Norco-College-Rocketry/ProxyBox/PCBs/5v Power Bus Board/5v Power Bus Board BOM.ods

DESCRIPTION | P/N | VALUE | QTY
USB TYPE C CONNECTOR SOLDER | USB4215-03-A |  | 1
USB TYPE B CONNECTOR SOLDER | USB1125-GF-B |  | 6
SCREW TERMINAL P3.5MM 2POS | 284391-2 |  | 4
JST XH 2POS | B2B-XH-A(LF)(SN) |  | 15
Capacitor | REF1225102M035K | 1000uF 35v | 2
Diode | 1n4005 |  | 1
