Norco-College-Rocketry/ProxyBox/PCBs/PaC Board/PAC Board BOM.ods

DESC. | P/N | Value | QTY
Test Point | 36-4952-ND | N/A | 5
Capacitor |  | 680uF 25v | 2
Capacitor | C1210C104K8GACTU | 0.1uF 10v | 1
Molex 6pos Female crimp Connector housing | 43645-0600 |  | 1
Molex 6pos male solder THT Connector Housing | 43650-0619 |  | 1
Terminal MF 3.0 | 43030-0001 |  | 18
Molex 4pos Male Solder THT Connector Housing | 43045-0428 |  | 3
Molex 4pos Female crimp connector housing | 172952-0401 |  | 3
Voltage & Current Monitor IC | LTC2990IMS#PBF |  | 1
Current Sense Resistor | WSLP39211L000FEB | 1mOhm | 1
