Norco-College-Rocketry/ProxyBox/PCBs/Relay Board/Relay Board BOM.ods

DESC. | P/N | Value | QTY
Molex 6pos Female crimp Connector housing | 43645-0600 |  | 1
Molex 6pos male solder THT Connector Housing | 43650-0619 |  | 1
Terminal MF 3.0 | 43030-0001 |  | 4
SCREW TERMINAL P3.5MM 3POS | 284391-3 |  | 4
Efuse | NIS6151MT1TXG | 5v 1A | 1
Capacitor | HMK325C7475MN-TE | 4.7uF | 1
Capacitor | C1210C105K8RACTU | 1uF | 1
Resistor | ESR25JZPF2R00 | 2Ohms | 1
Resistor | TNPW12101K00BEEA | 1kOhms | 1
