Norco-College-Rocketry/ProxyBox/PCBs/XBee Pro THT Mounting PCB/XBee Pro THT Mounting PCB.ods

Desc | P/N | Value | QTY
Capacitor | KAF32GR71H105KU | 1uF 50v | 1
Capacitor | CL32B106KBVVPLE | 10uF 50v | 1
Capacitor | CL32Y476KPVVPNE | 47uF 50v | 1
