Norco-College-Rocketry/ProxyBox/PCBs/Load Cell Amp Board/Load Cell Amp Board Schematic.pdf

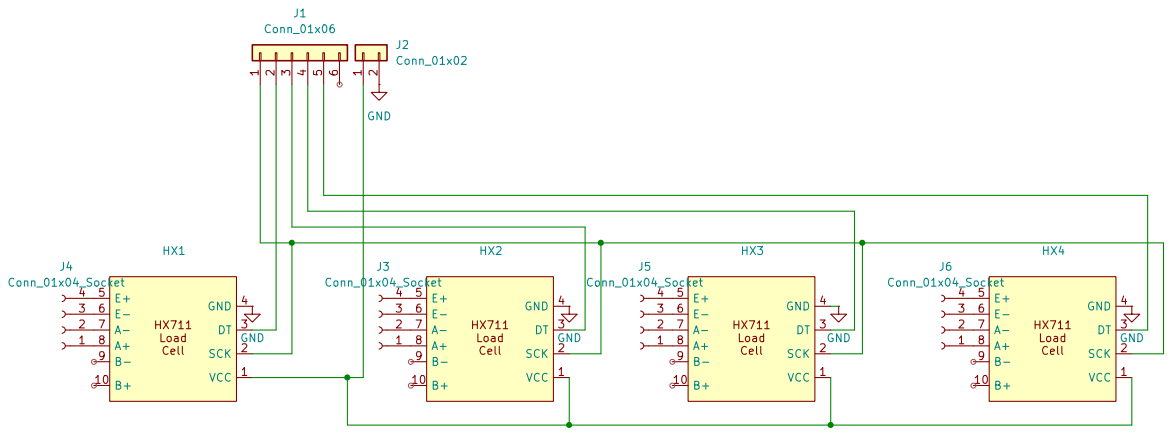
[picture p1: page 1]
