Norco-College-Rocketry/ProxyBox/PCBs/Load Cell Amp Board/Load Cell Amp Board.kicad_pcb

## KiCad design PCBs/Load Cell Amp Board/Load Cell Amp Board.kicad_pcb (2025-11-12)

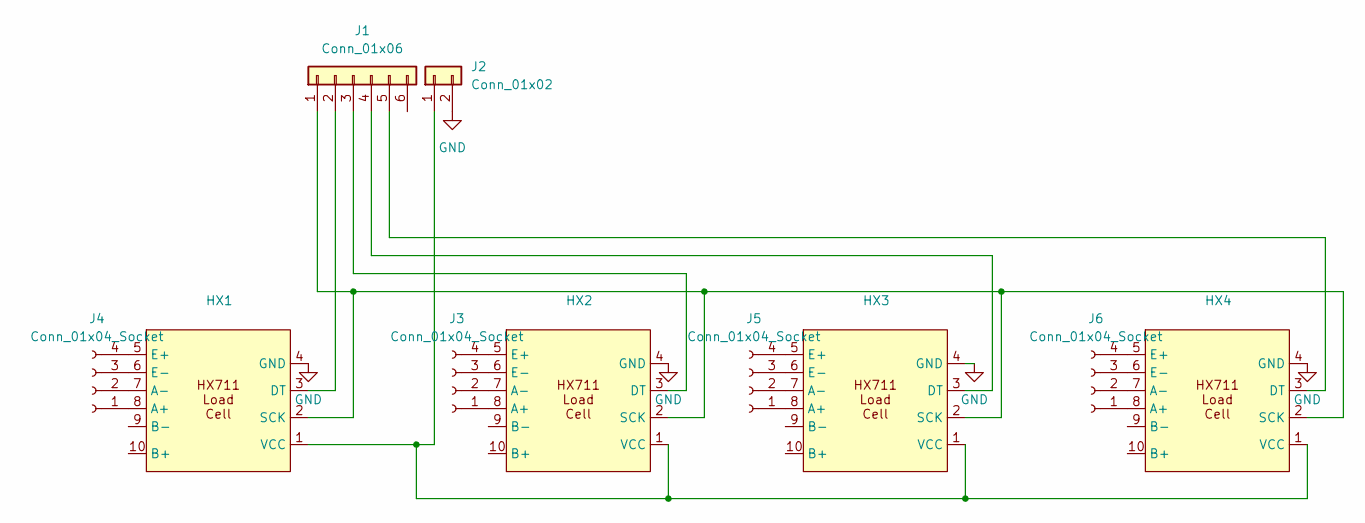
[picture p2: schematic Load Cell Amp Board.kicad_sch]

Parts:
HX1, HX2, HX3, HX4: HX711 Load Cell Amp Board
J1: Conn_01x06; Molex_Micro-Fit_3.0_43650-0619_1x06_P3.00mm_Vertical
J2: Conn_01x02; JST_XH_B2B-XH-A_1x02_P2.50mm_Vertical
J3, J4, J5, J6: Conn_01x04_Socket; Molex_Micro-Fit_3.0_43045-0412_2x02_P3.00mm_Vertical

Connections:
GND: HX1.4 (GND), HX2.4 (GND), HX3.4 (GND), HX4.4 (GND), J2.2
unnamed: HX1.8 (A+), J4.1
unnamed: HX1.7 (A-), J4.2
unnamed: HX1.3 (DT), J1.2
unnamed: HX1.5 (E+), J4.4
unnamed: HX1.6 (E-), J4.3
unnamed: HX1.2 (SCK), HX2.2 (SCK), HX3.2 (SCK), HX4.2 (SCK), J1.1
unnamed: HX1.1 (VCC), HX2.1 (VCC), HX3.1 (VCC), HX4.1 (VCC), J2.1
unnamed: HX2.8 (A+), J3.1
unnamed: HX2.7 (A-), J3.2
unnamed: HX2.3 (DT), J1.3
unnamed: HX2.5 (E+), J3.4
unnamed: HX2.6 (E-), J3.3
unnamed: HX3.8 (A+), J5.1
unnamed: HX3.7 (A-), J5.2
unnamed: HX3.3 (DT), J1.4
unnamed: HX3.5 (E+), J5.4
unnamed: HX3.6 (E-), J5.3
unnamed: HX4.8 (A+), J6.1
unnamed: HX4.7 (A-), J6.2
unnamed: HX4.3 (DT), J1.5
unnamed: HX4.5 (E+), J6.4
unnamed: HX4.6 (E-), J6.3

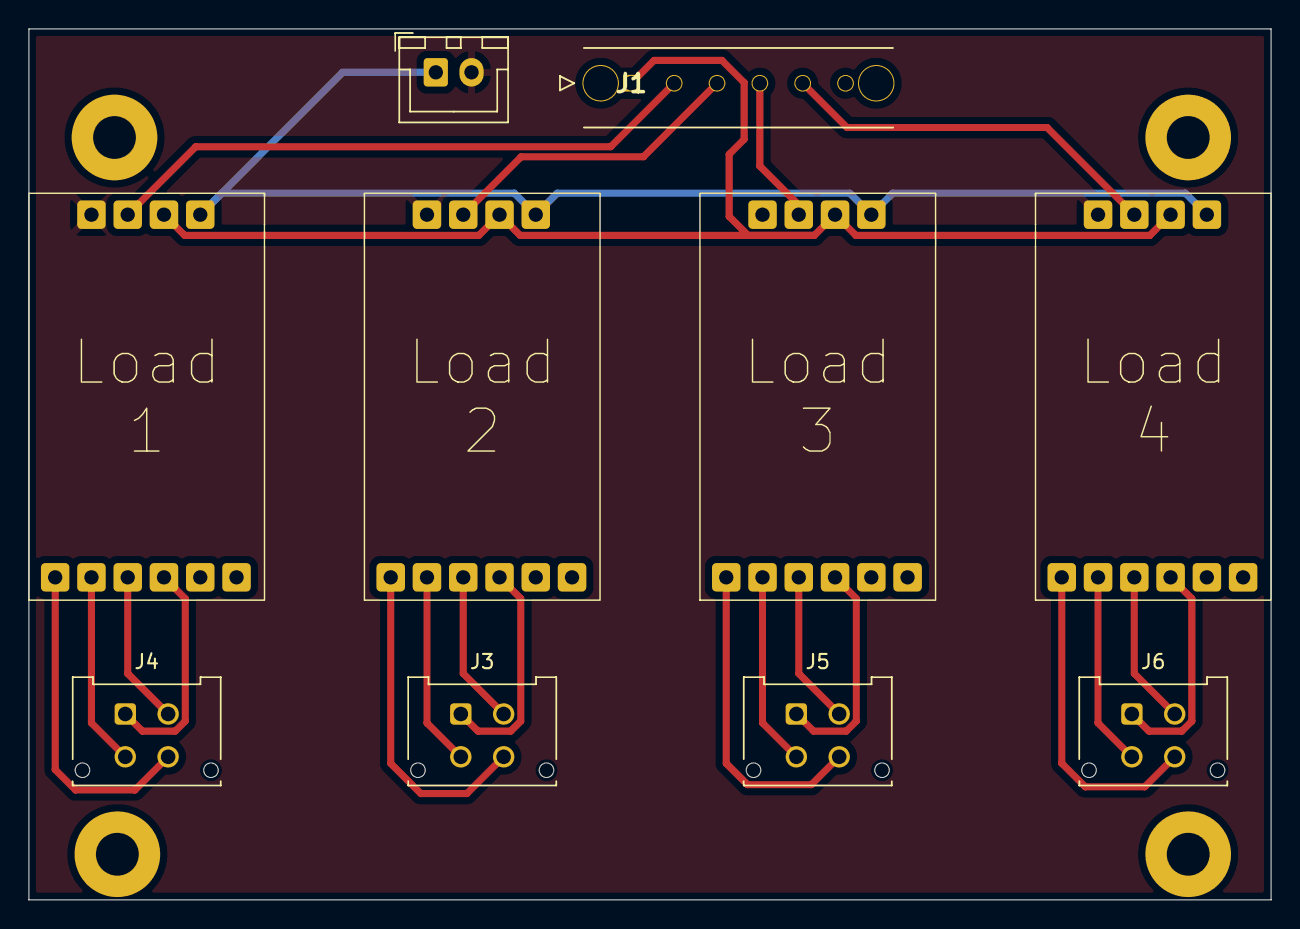
[picture p3: board Load Cell Amp Board.kicad_pcb from above]

Board: 2 copper layers, 87.0 x 61.0 mm, 10 parts (0 on the bottom side), 23 nets.
