Norco-College-Rocketry/ProxyBox/PCBs/5v Power Bus Board/5v Power Bus Board.kicad_pcb

## KiCad design PCBs/5v Power Bus Board/5v Power Bus Board.kicad_pcb (2025-11-12)

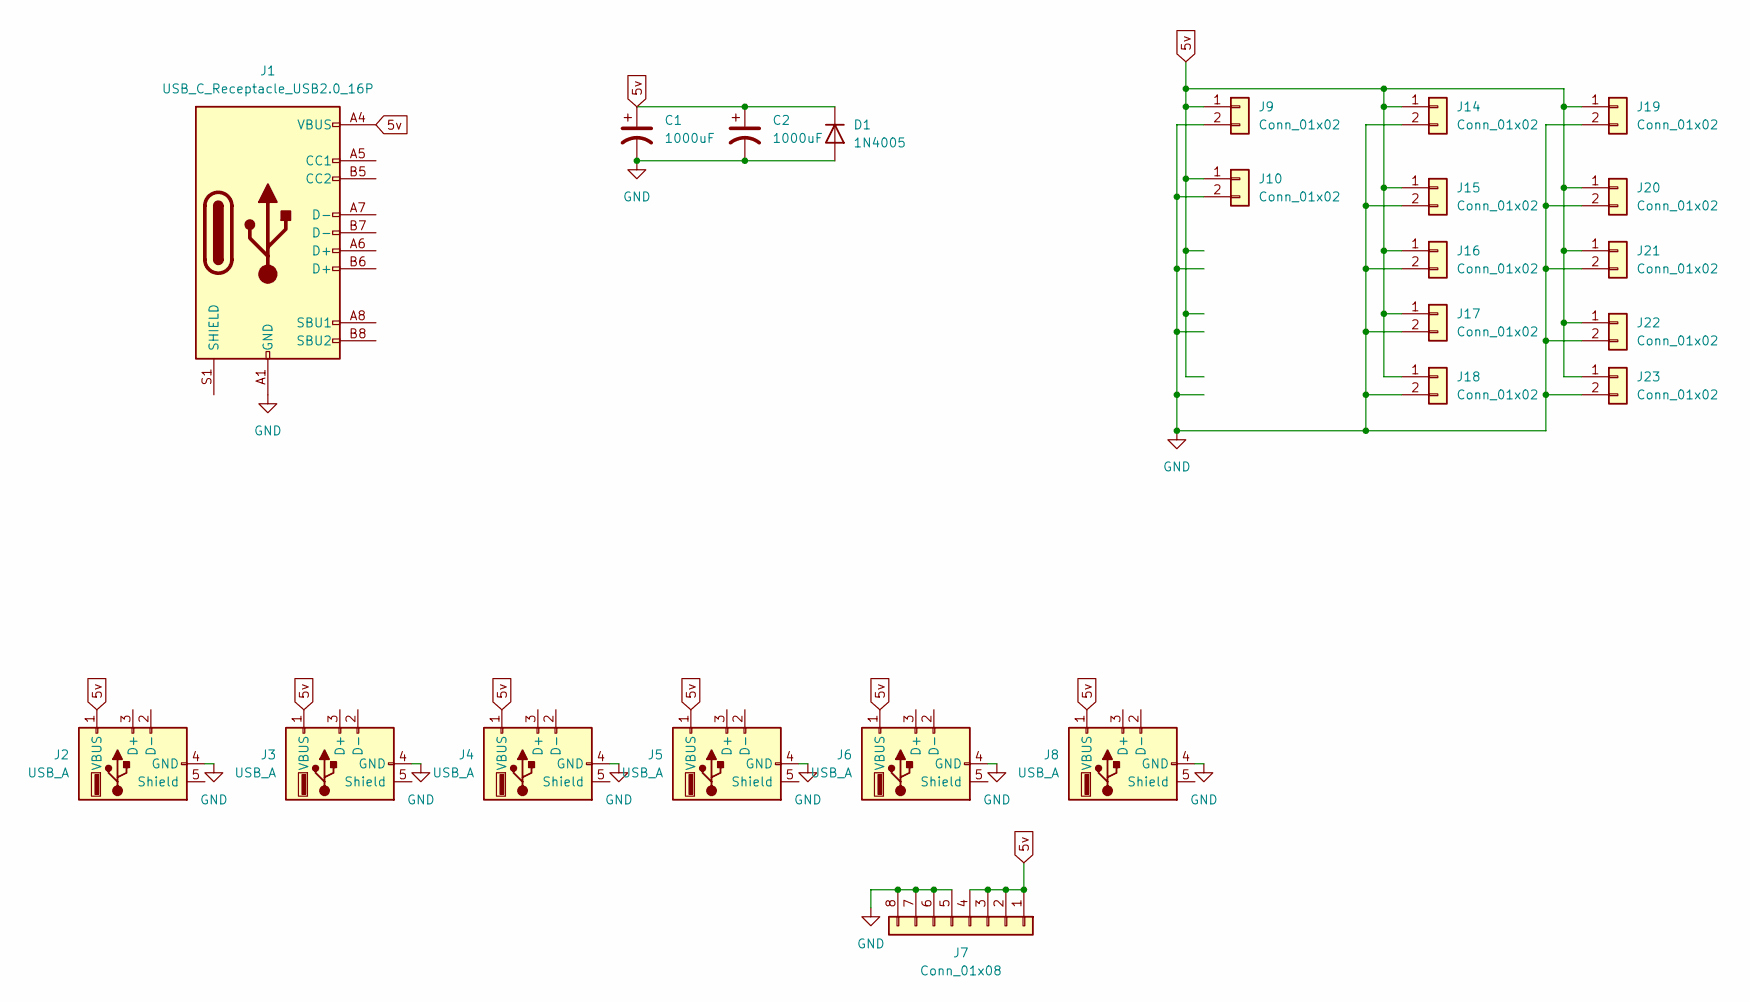
[picture p4: schematic 5v Power Bus Board.kicad_sch]

Parts:
C1, C2: 1000uF; CP_Radial_D12.5mm_P5.00mm
D1: 1N4005; D_DO-41_SOD81_P10.16mm_Horizontal
J1: USB_C_Receptacle_USB2.0_16P; USB_C_Receptacle_GCT_USB4105-xx-A_16P_TopMnt_Horizontal
J2, J3, J4, J5, J6, J8: USB_A; USB1125GFB
J7: Conn_01x08; TerminalBlock_4Ucon_1x08_P3.50mm_Horizontal
J9, J10, J14, J15, J16, J17, J18, J19, J20, J21, J22, J23: Conn_01x02; JST_XH_B2B-XH-A_1x02_P2.50mm_Vertical

Connections:
5v: C1.1, C2.1, D1.1 (K), J1.A4 (VBUS), J1.A9 (VBUS), J1.B4 (VBUS), J1.B9 (VBUS), J2.1 (VBUS), J3.1 (VBUS), J4.1 (VBUS), J5.1 (VBUS), J6.1 (VBUS), J7.1, J7.2, J7.3, J7.4, J8.1 (VBUS), J9.1, J10.1, J14.1, J15.1, J16.1, J17.1, J18.1, J19.1, J20.1, J21.1, J22.1, J23.1
GND: C1.2, C2.2, D1.2 (A), J1.A1 (GND), J1.A12 (GND), J1.B1 (GND), J1.B12 (GND), J2.4 (GND), J3.4 (GND), J4.4 (GND), J5.4 (GND), J6.4 (GND), J7.5, J7.6, J7.7, J7.8, J8.4 (GND), J9.2, J10.2, J14.2, J15.2, J16.2, J17.2, J18.2, J19.2, J20.2, J21.2, J22.2, J23.2

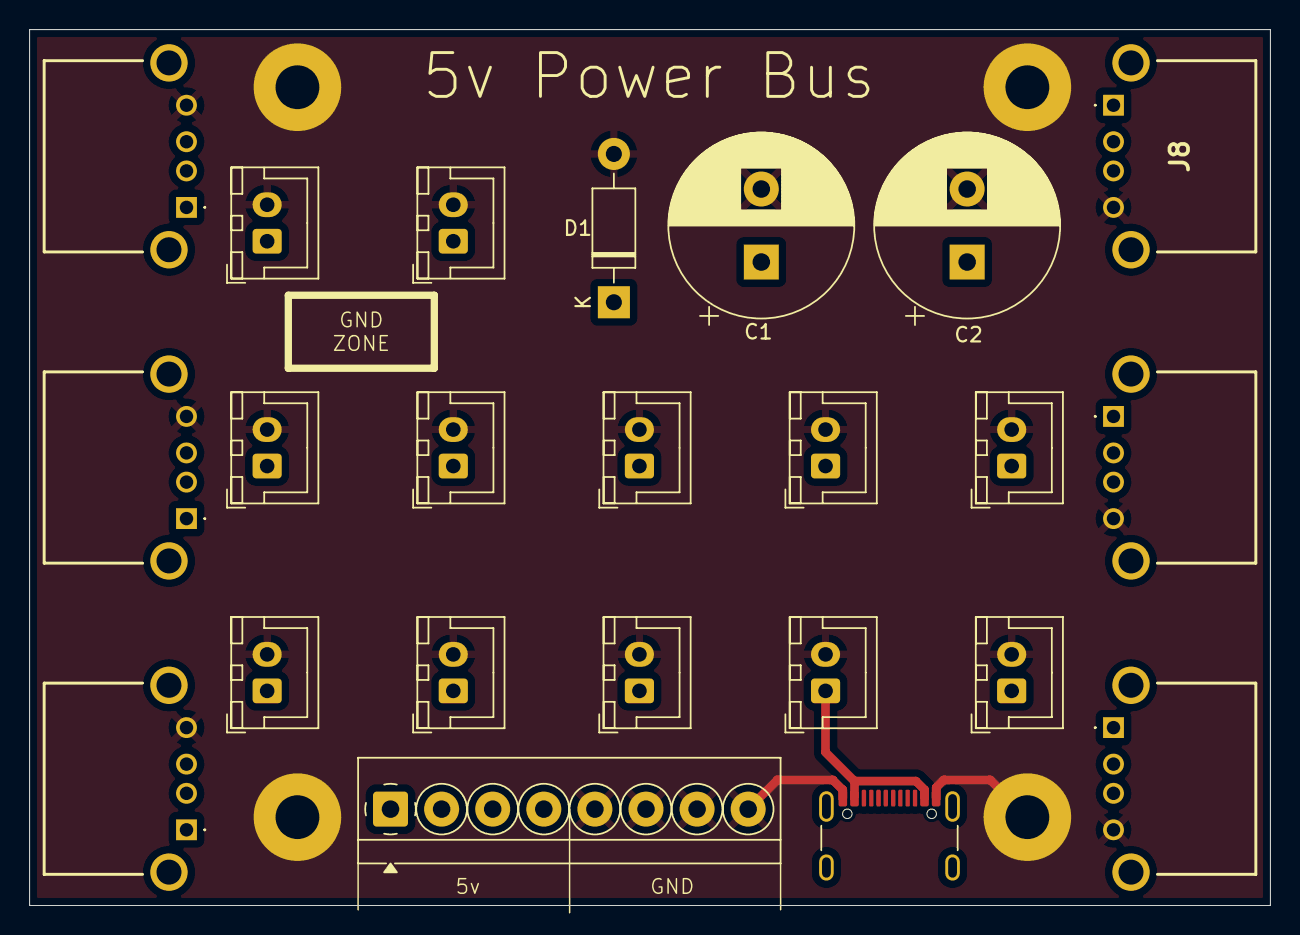
[picture p5: board 5v Power Bus Board.kicad_pcb from above]

Board: 2 copper layers, 85.0 x 60.0 mm, 23 parts (0 on the bottom side), 2 nets.
