Norco-College-Rocketry/ProxyBox/PCBs/Relay Board/Relay Board.kicad_pcb

## KiCad design PCBs/Relay Board/Relay Board.kicad_pcb (2025-11-12)

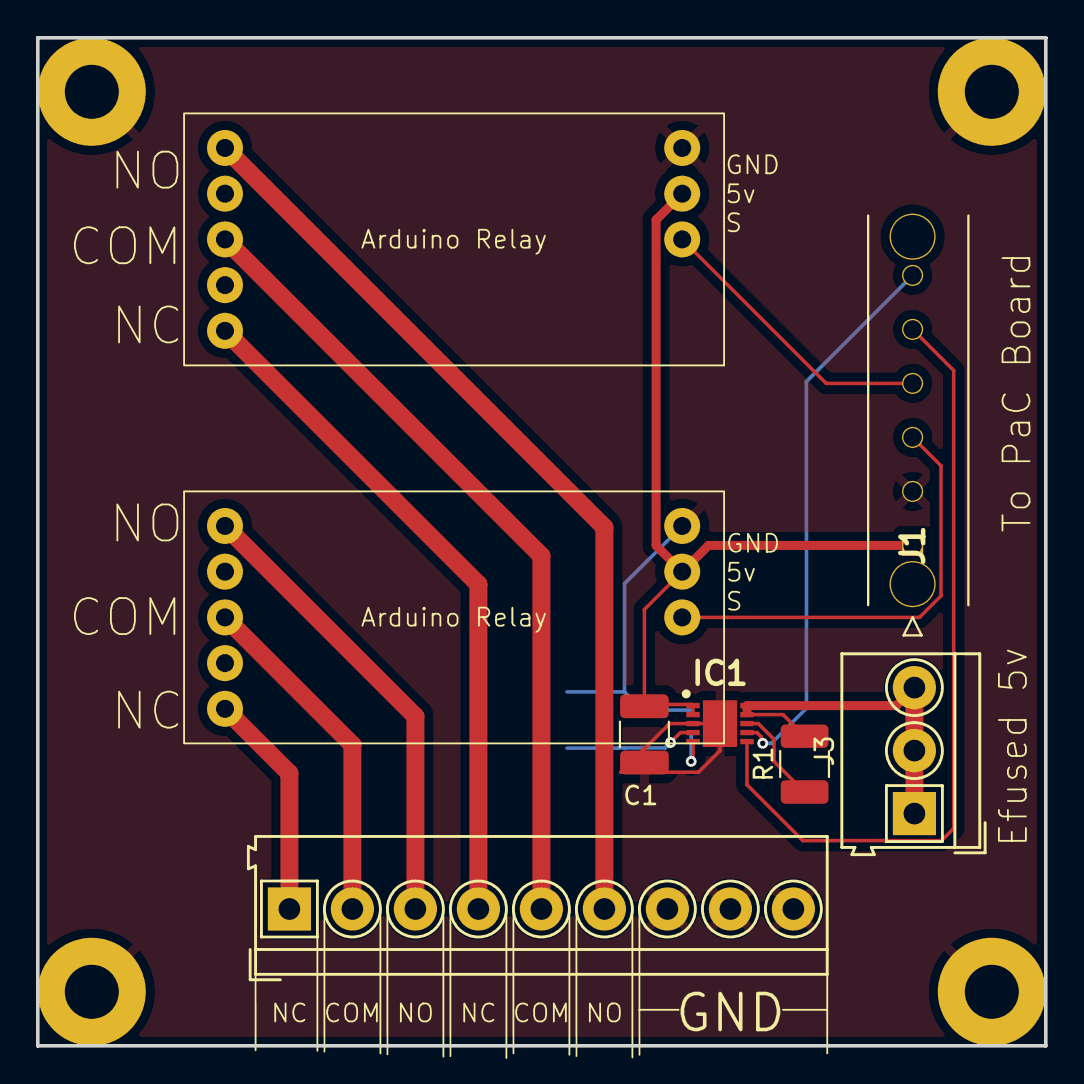
[picture p6: board Relay Board.kicad_pcb from above]

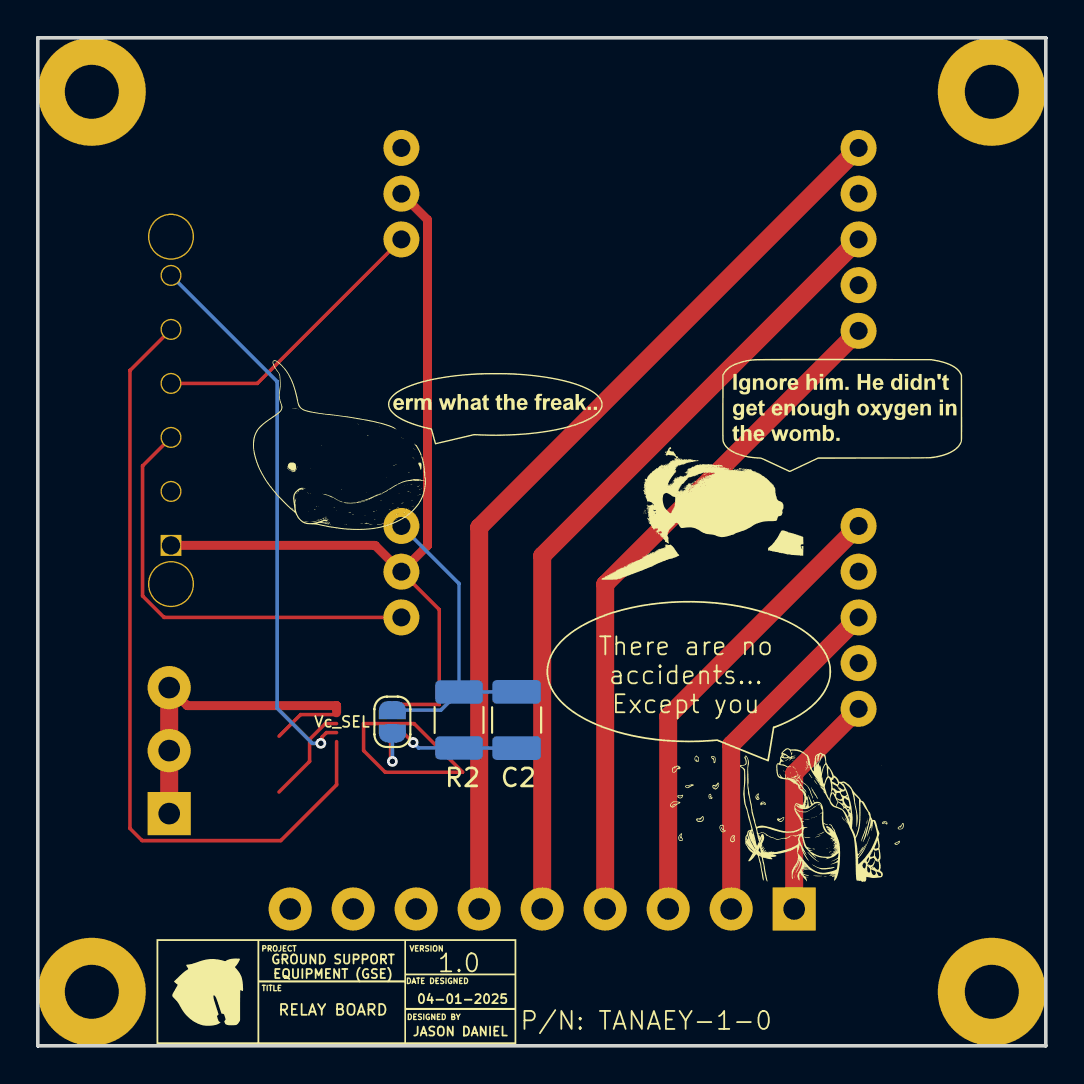
[picture p7: board Relay Board.kicad_pcb from below]

Board: 2 copper layers, 56.0 x 56.0 mm, 11 parts (3 on the bottom side), 16 nets.

Parts:
C1: 4.7uF; C_1210_3225Metric_Pad1.33x2.70mm_HandSolder
C2: 1uF; C_1210_3225Metric_Pad1.33x2.70mm_HandSolder
IC1: NIS6150MT1TXG; [NIS6150MT1TXG] Efuse
J1: Conn_01x06; Molex_Micro-Fit_3.0_43650-0619_1x06_P3.00mm_Vertical
J2: Conn_01x09; PCB_Terminal_Block_9_DEG381-3.5
J3: Conn_01x03; PCB_Terminal_Block_3_DEG381-3.5
JP2: SolderJumper_2_Open; SolderJumper-2_P1.3mm_Open_RoundedPad1.0x1.5mm
K1, K2: Arduino_Relay_5v; 5v Arduino Relay
R1: 2ohm; R_1210_3225Metric_Pad1.30x2.65mm_HandSolder
R2: 1kohm; R_1210_3225Metric_Pad1.30x2.65mm_HandSolder

Connections:
5v: C1.1, IC1.1 (VCC_1), IC1.2 (VCC_2), J1.1, K1.2 (5v), K2.2 (5v)
GND: C1.2, C2.2, IC1.3 (GND), IC1.11 (EP), J1.2, J2.7, J2.8, J2.9, JP2.1 (A), K1.3 (Gnd), K2.3 (Gnd), R2.1
unnamed: IC1.7 (EN), J1.6
unnamed: IC1.6 (FLAG), J1.5
unnamed: IC1.8 (ILIM), R1.1
unnamed: C2.1, IC1.4 (IMON), R2.2
unnamed: IC1.9 (SRC_1), IC1.10 (SRC_2), J3.1, J3.2, J3.3, R1.2
unnamed: IC1.5 (VC_SEL), JP2.2 (B)
unnamed: J1.3, K1.1 (Signal)
unnamed: J1.4, K2.1 (Signal)
unnamed: J2.1, K1.6
unnamed: J2.2, K1.5
unnamed: J2.3, K1.4
unnamed: J2.4, K2.6
unnamed: J2.5, K2.5
unnamed: J2.6, K2.4
