Norco-College-Rocketry/ProxyBox/(threads)

Thread 4 (2025-01-30):

LED Indicators

ahthae, 2025-01-30:
Indicator lights for status, warning, and error (blue, amber, and red, perhaps) to assist with debugging and on-pad operations.
