Norco-College-Rocketry/ProxyBox/(commit log)

2025-01-07 Initial commit Read telemetry from CAN bus Blink relays
2025-01-07 Changed packet type cause i had voltage originally
2025-01-16 Add HX711 ADC library to PIO project
2025-01-21 Fix pin assignments
2025-01-28 Fix type; assert relay 2 low
    [main.cpp]
2025-01-29 Restore PT calibration debug commands
2025-02-05 Implement valve command
2025-02-07 Fix valve comand packet Use else-if's instead of if's to parse received command
    [main.cpp]
2025-02-08 Use valve command packet type define Rename read_float to parse_float
2025-02-12 Extract sending valve command to a function
2025-02-16 Fix updating load cell amplifiers
    [main.cpp]
2025-02-16 Publish thrust telemetry
2025-05-06 Update pins for new PCB Update P&ID numbers & MQTT topics Add launch command Retry CAN initialization periodically on startup
